mashabow/uruoi/schematics/uruoi.sch

## KiCad design schematics/uruoi.sch (2021-06-21)

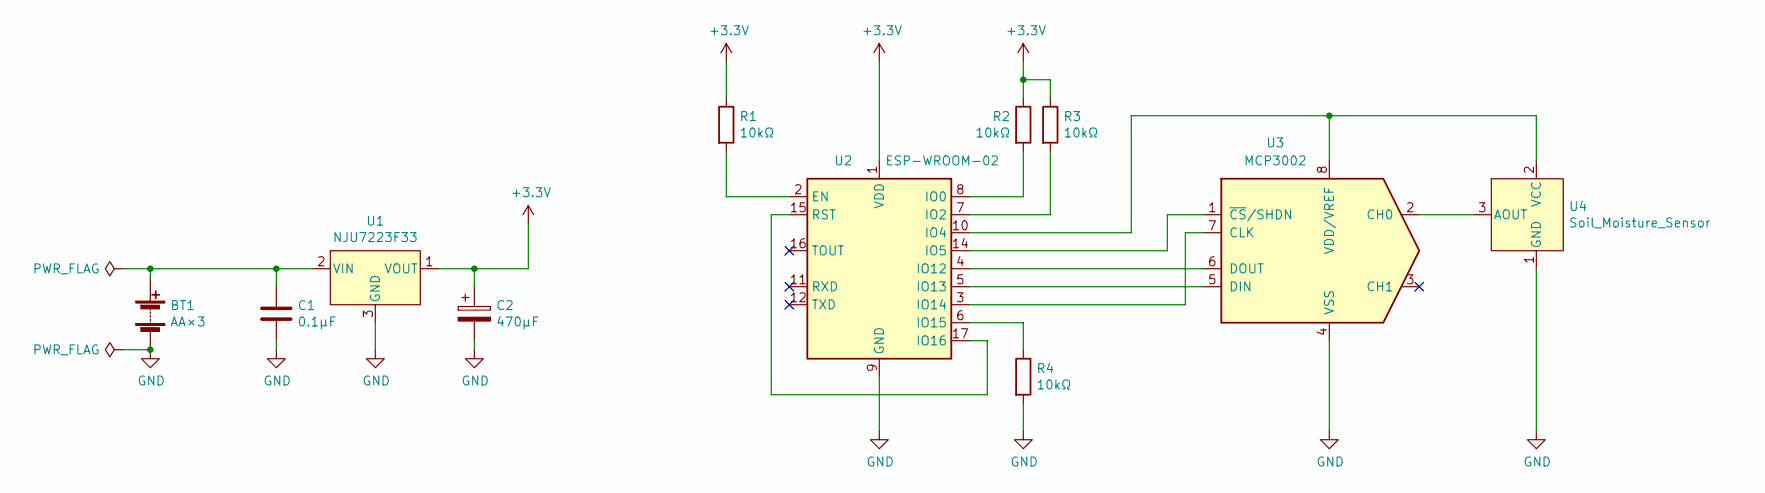
[picture p1: schematic uruoi.sch]

Parts:
BT1: AA×3
C1: 0.1μF
C2: 470μF
R1, R2, R3, R4: 10kΩ
U1: NJU7223F33
U2: ESP-WROOM-02
U3: MCP3002
U4: Soil_Moisture_Sensor

Connections:
+3.3V: C2.1, R1.1, R2.1, R3.1, U1.1 (VOUT), U2.1 (VDD)
GND: BT1.2 (-), C1.2, C2.2, R4.2, U1.3 (GND), U2.9 (GND), U2.13 (GND), U2.18 (GND), U2.19 (GND), U3.4 (VSS), U4.1 (GND)
unnamed: BT1.1 (+), C1.1, U1.2 (VIN)
unnamed: R1.2, U2.2 (EN)
unnamed: R2.2, U2.8 (IO0)
unnamed: R3.2, U2.7 (IO2)
unnamed: R4.1, U2.6 (IO15)
unnamed: U2.3 (IO14), U3.7 (CLK)
unnamed: U2.4 (IO12), U3.6 (DOUT)
unnamed: U2.5 (IO13), U3.5 (DIN)
unnamed: U2.10 (IO4), U3.8 (VDD/VREF), U4.2 (VCC)
unnamed: U2.14 (IO5), U3.1 (~CS~/SHDN)
unnamed: U2.15 (RST), U2.17 (IO16)
unnamed: U3.2 (CH0), U4.3 (AOUT)
