mashabow/uruoi/(threads)

Thread 1 (2021-05-25):

水やりする際の土壌水分量の閾値を決める

mashabow, 2021-05-25:
しばらく手動水やりで運用して、Ambient で水分量の変化を記録する。

土の乾き具合を見ながら、水やり実行の条件を決める。

mashabow, 2021-05-29:
測定 6 日目、水分量 66.9% のとき（15:35）に、500mL 水やりしてみた。

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

測定値は、それほど急激に変化するわけではない様子。水やりの量にも依存するとは思うが。

3時間かけて、69.2% まで上昇。+2.3 ポイント。

mashabow, 2021-06-05:
測定値が安定しない 😣

おそらく、下側の包絡線が真の値に近いとは思うが…。

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

期間中の水やりは ↑ で示した 2 回だけ。

mashabow, 2021-06-05:
> 測定値が安定しない 😣

乾電池3本で動かしていたが、電源電圧が 3.3V（1.1V × 3本）程度に低下していた。

電池を交換したら戻った。

測定値が 100% を超えていたのも、おそらく電圧低下の影響。センサーに入力する電圧が低くなると、センサーの出力電圧 `analogRead(A0)` の値も低くなるので、水分量は計算上高くなる。

mashabow, 2021-06-06:
> 測定値が 100% を超えていたのも、おそらく電圧低下の影響。センサーに入力する電圧が低くなると、センサーの出力電圧 `analogRead(A0)` の値も低くなるので、水分量は計算上高くなる。

確認してみた。横軸はセンサーに入力する電圧 [V]、縦軸はセンサーの出力電圧を分圧して `analogRead(A0)` で読み取った値。センサーは空気中に置いた。

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

入力電圧が 3.3V 以下になると、出力電圧もほぼ線形に低下する。入力電圧が 3.3V 以上であれば、出力は一定になる。

mashabow, 2021-06-06:
> センサーの回路図によれば

ちなみに、https://so-now.com/electronics/capsense.php によれば、正しい回路図は以下らしい。

> 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

mashabow, 2021-06-23:
#5 で電源電圧を測るようにしたので、とりあえずこれで気づけるはず。

Thread 3 (2021-05-25):

タンクの水がなくなりそうになったら通知する

mashabow, 2021-05-25:
細かい水位はわからなくてもいい。2値で十分。

フロートスイッチを使う？

- [Arduinoでフロートスイッチ(定水位スイッチ)を使ってみた - Grow up](https://knkomko.hatenablog.com/entry/2019/09/21/230310)

電極2本を入れて抵抗値を見るだけでもいいかも。

Thread 4 (2021-05-28):

回路図を書く

mashabow, 2021-05-28:
https://github.com/mashabow/uchino-sensors では Fritzing を使ったけど、使い勝手がいまいち…

何がいいんだろう。Eagle と KiCad がメジャーっぽい。

mashabow, 2021-06-21:
KiCad で参考にしたサイト。今回は基板までは使わないが…

- [最短でKiCadを使えるようになりたい - manvaのエンジニアリング魂](https://manva.hatenablog.com/entry/2020/09/22/201819)
- [KiCadことはじめ](https://docs.kicad.org/master/ja/getting_started_in_kicad/getting_started_in_kicad.pdf)
- [KiCadで雑に基板を作るチュートリアル Ver6.x 予習版 - Speaker Deck](https://speakerdeck.com/tokitahiroshi/kicaddeza-niji-ban-wozuo-rutiyutoriaru-ver6-dot-x-yu-xi-ban)

mashabow, 2021-06-21:
.gitignore

- [gitignore file for KiCAD projects](https://gist.github.com/jmptable/3eca532fd16eb6abfe6b6379dc1146d4)
- [KiCadプロジェクトのgitignoreのテンプレート - masahirosuzuka's blog](https://masahirosuzuka.hatenablog.com/entry/2015/09/01/192223)

Closed 2021-06-21.

Thread 5 (2021-06-06):

電源電圧を測る

mashabow, 2021-06-06:
https://github.com/mashabow/uruoi/issues/1#issuecomment-855209607 のとおり、電源（乾電池）の電圧が低下してくると、正確な水分量が取得できなくなる。そこで、電源の電圧も測定したい。

- [省電力でESP32の電源電圧を自己計測してみた / kghr IT備忘録　](https://kghr.blog.fc2.com/blog-entry-135.html)

ただし、ESP8266 にはアナログ入力が1端子（TOUT）しかないので注意。電源電圧と水分量、2つのアナログ値を取得したい。

- トランジスタを使った例
    - [2軸ジョイスティックをアナログピン一つとデジタルピン一つで読み取る | Program Resource](https://programresource.net/2020/03/27/3194.html)
- ダイオードを使った例
    - [How to Read Multiple Analog Values Using One Analog Pin - Arduino Project Hub](https://create.arduino.cc/projecthub/e_s_c/how-to-read-multiple-analog-values-using-one-analog-pin-f5f6db)
    - [ESP8266 ADC - Multiple Analog Sensors : 3 Steps - Instructables](https://www.instructables.com/ESP8266-with-Multiple-Analog-Sensors/)
- ADコンバータを使った例
    - [アナログピンを増設する「ADコンバータ」の使い方 \[Arduino\]](https://www.petitmonte.com/robot/howto_ad_converter.html)

ESP8266 では以下のコードで電源電圧を取得することができるが、この機能を使うとアナログ入力が使えない。

```c++
ADC_MODE(ADC_VCC);

ESP.getVcc();
```

- [Reference — ESP8266 Arduino Core 3.0.0-18-g74d675cf documentation](https://arduino-esp8266.readthedocs.io/en/latest/reference.html#analog-input)

Closed 2021-06-19.
