mashabow/uruoi/include/secrets.template.h

// secrets.h にコピーし、値を書き換えて使うこと

constexpr char WIFI_SSID[] = "**********";
constexpr char WIFI_PASSWORD[] = "**********";

constexpr unsigned int AMBIENT_CHANNEL_ID = 0000000;
constexpr char AMBIENT_WRITE_KEY[] = "**********";
