mashabow/uruoi/(commit log)

2021-05-22 feat: get soil moisture value from the sensor
2021-06-17 feat: read analog input from a MCP3002 external ADC
2021-06-17 feat: control power supply for the sensor and the ADC
2021-06-21 chore: ignore kicad temp files
2021-06-21 docs: add KiCad schematic files for this circuit
    [uruoi.sch]
